Qrome/QLiteOSD/images/preview.jpg

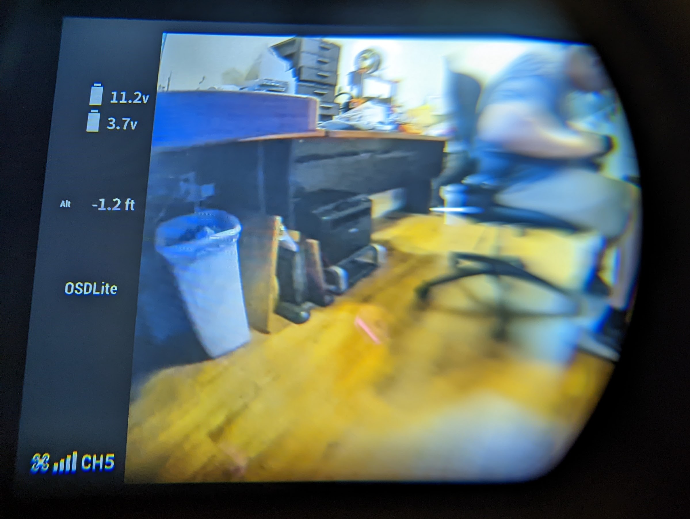
images/preview.jpg
