Qrome/QLiteOSD/images/PXL_20220612_231718759.jpg

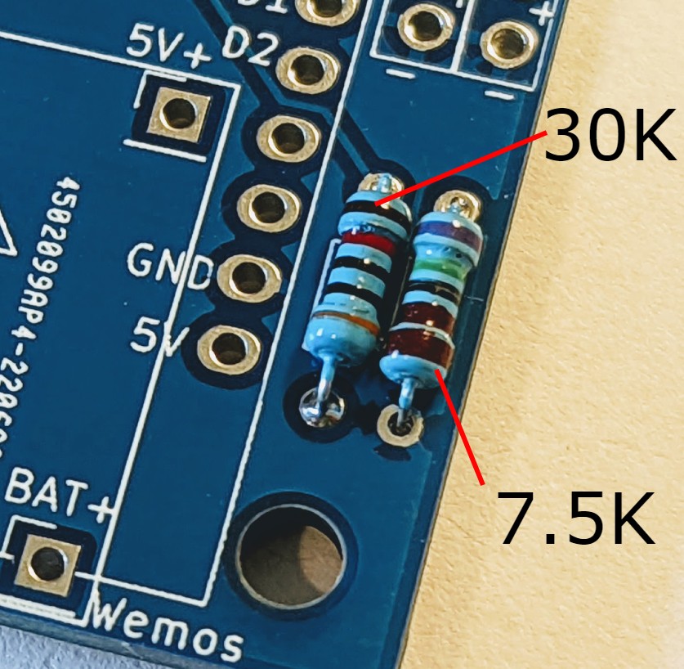
images/PXL_20220612_231718759.jpg
