Qrome/QLiteOSD/images/testing_unit.jpg

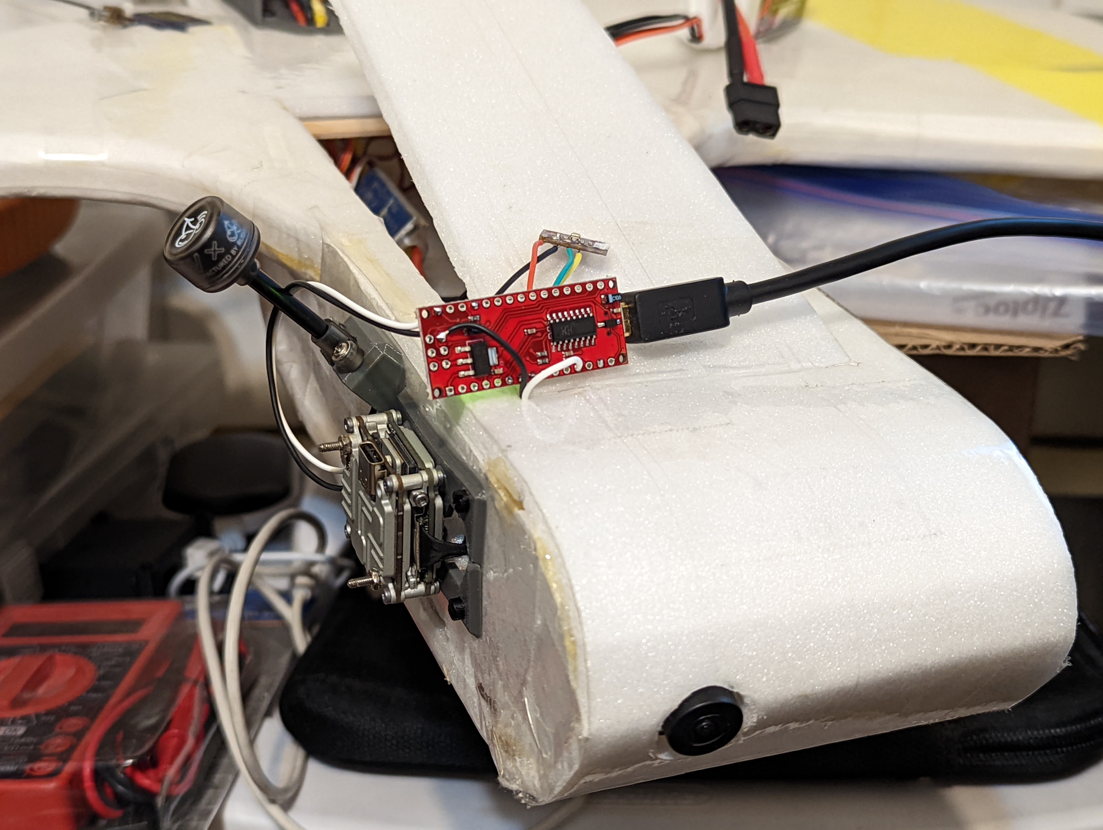
images/testing_unit.jpg
