Qrome/QLiteOSD/(threads)

Thread 1 (2022-09-04):

Add current sensor

01Space, 2022-09-04:
The DJI OSD you designed is very good! Can you add current sensor and qmc5883l?

01Space, 2022-09-06:
I am using esp8285s to design a customized version of DJI OSD, including current sensor and PDB, bec

Closed 2022-09-27.

Thread 2 (2023-01-17):

Instructions for using arduino nano

3dpete, 2023-01-17:
Hi  great project
I see you have arduino nano as an option as possible hardware on the parts list but no instructions on how to set up ? I wanted to use the nano as I have a few lying around Cound you add how to use I asked painless 360 as you reference his set up video but he was not sure ?
Any advice would be appreciated.

Qrome, 2023-01-19:
It has been a while since I initially coded and tested with the Arduino Nano, but I think it may still work.
In the OSD_positions_config.h -- fine the line:
`#define ESP8266`
and comment that out.

The reason I stopped working with the Nano was it was more expensive than the Wemos D1 Mini and you don't get the speed or logging (memory) that you get with the ESP8266 core.

You will also have to read through the code in the INO file for the pins -- they are there.

3dpete, 2023-01-19:
Hi I managed to get it working on arduino nano.  barro is working and osd
display is working but voltage is just showing 0v have set up with voltage
divider as your recommendation on pin a0 but not getting read out any ideas
why would be helpful. Thanks

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

Qrome, 2023-01-19:
I am quite sure the Voltage divider should work on the Nano as that is where I originally tested it out.  I don't know, off the top off my head, why you would not be able to read the voltage.

3dpete, 2023-01-19:
thanks for getting back to me so fast, could it be anything to do with
speed/refresh rate? I'm not a coder, just have a little knolage how to
compile and comment in/out things from the multi wii days ?:)
I have an esp8266 nodemcu with wifi I found in my parts bin would this also
work?
would love to get this working maybe I just get the wemos d1  is it
thanks pete

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

Qrome, 2023-01-19:
I have also created a more simple version called VoltOSD using the XIAO SAMD21

 *  VoltOSD
 *
 *  XIAO SAMD21 TX to DJI Air unit RX(115200)
 *  Voltage sensor on A0 pin 0
 *  PWM Arm Signal on D1 pin 1

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

https://github.com/Qrome/VoltOSD

3dpete, 2023-01-19:
that looks great supper compact !!  dude your a wizard, using the
balance lead is a great idea. xiao board is a little more expensive from
what I can see, would still love to get it working on the nano  as I have a
bag of 10 of them left over from a old project just need to get the volts
showing will play with it tonight a little more. see if I can work it out
did try to us the serial monitor to see if I could see volt read out on
that. could it be that I have the dji unit set up for inav on wtfos hack so
using compressed transmission msp? blow is cut and past from wtfos wiki so
you can see

Compressed Transmission

As of 0.7.0, a new option, compress_osd, has been added to the air side
process.

If this is set to "true", then the entire character buffer will be sent
using LZ4 compression at the rate defined in osd_update_rate_hz, instead of
sending raw MSP messages over the air.

When enabled, this should fix INAV delta update related issues as well as
provide better link stability.

To enable:

Use the CLI button in the configurator on your VTx side after updating to
0.7.0.

package-config set msp-osd compress_osd true
package-config apply msp-osd

If the apply hangs, just reboot your VTx.

Note that INAV HD mode sync issues may still be present, use the usual
workarounds (enter menu or switch screens) to fix these.

Compressed mode may also be valuable for other FCs, as it should make the
overall link much more reliable and stable

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

3dpete, 2023-01-19:
would i need to change anthing in here pasted code below  for  voltage read
out to work on nano?.
 and also can I just change the
 analogPin =  A0
to a different pin ?
in here to check if the problem is the pin i.e can I just change to A2 ? or
will it break the code somewhere else ?

//Voltage and Battery Reading
#ifdef ESP8266
const float arduinoVCC = 3.25;  //Measured ESP8266 3.3 pin voltage
#else
const float arduinoVCC = 5.0;  //Measured Arduino 5V pin voltage
#endif
float ValueR1 = 7500;   //7.5K Resistor
float ValueR2 = 30000;  //30K Resistor
const int alanogPin = A0;
float averageVoltage = 0;
int sampleVoltageCount = 0;other to see if the my a0 pin is broken ?

On Thu, 19 Jan 2023 at 17:59, peter houghton ***@***.***>
wrote:

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

3dpete, 2023-01-19:
did work still trying

ramiss, 2023-07-30:
Please note that this project has switched to using the Seeeduino SAM21 chipset.

Thread 3 (2023-07-01):

issues disarming?

ramiss, 2023-07-01:
Hi there!  Thanks for this code.  Its working great for me and the DJI air unit arms and starts recording.  the issue is that the air unit won't respond to a disarm msp command.  Have you seen this issue and do you have any insight?

Thanks!

Qrome, 2023-07-02:
The QLiteOSD defaults to arm with the change in altitude -- it does not know anything about your disarm from your radio unless you have compiled and turned on the option USE_PWM_ARM  --when using this option you can define a switch to arm and disarm if you run a signal and ground from your RC Rx channel to D5 pin.    Otherwise, you only get the arm action when there is a change in altitude of 1.5 meters.  I hope that helps.

ramiss, 2023-07-02:
> The QLiteOSD defaults to arm with the change in altitude -- it does not know anything about your disarm from your radio unless you have compiled and turned on the option USE_PWM_ARM --when using this option you can define a switch to arm and disarm if you run a signal and ground from your RC Rx channel to D5 pin. Otherwise, you only get the arm action when there is a change in altitude of 1.5 meters. I hope that helps.

Hey and thanks for the response.  Apologies as I wasn't nearly clear enough.  I'm using the same dji flightmodeflags as you to arm and disarm in my own project and although the arm flag works, the disarm flag rarely works.  its weird, because it works about 1 in 5 times on my 03 air unit (which should be using the same msp protocols as the original air unit/caddx).  I was curious if you've had similar issues with your code?

Qrome, 2023-07-02:
It works in my code.   I have not looked at that code for a while but I use it and is working.

PPPRY, 2023-07-11:
I can not get the latest code to upload using a ESP32-S3-Box has anyone run into any issues flashing? Compilation error: 'LED_BUILTIN' was not declared in this scope @ramiss

ramiss, 2023-07-11:
> I can not get the latest code to upload using a ESP32-S3-Box has anyone run into any issues flashing? Compilation error: 'LED_BUILTIN' was not declared in this scope @ramiss

So first of all, I'm not the owner of this code, this thread was for my issue.  Second, you need to post your own issue as your problem has nothing to do with not disarming.

PPPRY, 2023-07-11:
> > I can not get the latest code to upload using a ESP32-S3-Box has anyone run into any issues flashing? Compilation error: 'LED_BUILTIN' was not declared in this scope @ramiss
>
> So first of all, I'm not the owner of this code, this thread was for my issue. Second, you need to post your own issue as your problem has nothing to do with not disarming.

Gotcha thanks for reaching out first time posting!

PPPRY, 2023-07-11:
> I can not get the latest code to upload using a ESP32-S3-Box has anyone run into any issues flashing? Compilation error: 'LED_BUILTIN' was not declared in this scope

Sorry disregard this..

Closed 2023-07-02.

Thread 4 (2023-07-20):

Support the battery to 6s

astray1988, 2023-07-20:
I would expect to have 6s battery(4.2v for Lipo, 4.35 for LiHV) supported in the future release.

Qrome, 2023-07-20:
It is a hardware limitation.   The you can run what ever your voltage stepdown can handle.   Also, you need to also stay under the voltage limit of your DJI video transmitter unless you use a voltage step down for that as well.   There will be no code changes for this request.

Closed 2023-07-20.

Thread 6 (2024-01-07):

Cannot flash device

Iamyahodfpv, 2024-01-07:
I downloaded the drivers and the device shows up as com3 but when I try to flash nothing happens. Also when plugged in the blue led flashes and then turns off.

Qrome, 2024-01-07:
Make sure you are using a data cable and not just a charging cable.   Try a new cable and a different USB Port.  This is not a software issue.

Iamyahodfpv, 2024-01-07:
I've tried different cables and I am using a data cable. Is it possible that I bricked it? Also can it be flashed through arduino IDE or does it have to be flashed with the PYflasher?

Iamyahodfpv, 2024-01-07:
Tried uninstalling and reinstalling the Pyflasher and the serial port showed up but now when I try to flash it is stuck on connecting

Iamyahodfpv, 2024-01-07:
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

Qrome, 2024-01-07:
Remove the board from the socket and just load it to the wemos d1 mini ... I have seen bridged soldering cause the board to not connect.

Qrome, 2024-01-07:
Yes, you can compile and load the firmware using Arduino IDE.

Iamyahodfpv, 2024-01-07:
Yep that did the trick. Now just need to figure out what's bridged

Qrome, 2024-01-07:
Post some photos of the top and bottom of the main board.   Did you do the button for the Wifi mode?   Check that the D3 and GND are not connected.

Thread 7 (2024-01-19):

GPS not working

Iamyahodfpv, 2024-01-19:
I currently have a foxeer m10 wired up and am not getting any gps info.

Qrome, 2024-01-19:
Are you seeing any of the other OSD elements?

Iamyahodfpv, 2024-01-19:
Yes, just not getting info from the gps

Iamyahodfpv, 2024-01-19:
The gps elements are there but no values show up

Iamyahodfpv, 2024-01-19:
The gps is a m10q 250, is there something I need to change in the config?

Iamyahodfpv, 2024-01-19:
Also the baud rate is 115200

Qrome, 2024-01-19:
You can change the baud rate in the firmware and compile it on your own.   The default is expecting 9600.   If you need me to compile it, let me know.

Qrome, 2024-01-19:
It is part of the QLiteOSD.ino code.   Near line 58.

`static const uint32_t GPSBaud = 9600;`

Change 9600 to 115200 and compile it.   If you are not able to compile it, let me know the options you want and I can do it for you.

Iamyahodfpv, 2024-01-19:
Well when I plugged the board back in I didn’t have the pins lined up and I think I may have bricked it. Is there a way to fix that?

Iamyahodfpv, 2024-01-19:
Now I’m just getting a solid blue light and no osd

Qrome, 2024-01-19:
Yeah, reversing the plugs can toast the Wemos D1 Mini board -- good news is you can replace those.

Iamyahodfpv, 2024-01-19:
Is it worth trying to uninstall and reinstall the drivers? It doesn’t smell like I smoked anything.

Iamyahodfpv, 2024-01-19:
I didn’t plug it in the wrong way just miss aligned the pins by one slot

Qrome, 2024-01-19:
I have seen it toast the Wemos D1 mini if the pins get plugged in wrong.   Solid light or not light is an indicator.   Remove the Wemos D1 mini from the socket and try to run it off the USB cable and or load it again -- if it will not load of the LED start flashing then it got toasted.   They are easy to replace.

Iamyahodfpv, 2024-01-19:
Yeah not getting anything when plugged into usb, it shows up but won’t connect

Qrome, 2024-01-19:
Yeah, sorry to hear that.

Iamyahodfpv, 2024-01-21:
Okay so I got the new board, flashed it but when I plug it in I'm not getting anything. No flashing led when plugged into the board but it does flash when plugged into my computer

Qrome, 2024-01-22:
That's an indicator that there might be a bad solder joint or joined pins.  Did you solder the d3 pin and gnd for wifi mode?  If so, make sure that is correct.

Qrome, 2024-01-22:
Post some photos of the board.

Iamyahodfpv, 2024-01-22:
It was the button for the WiFi, removed it and now it works. But still am not getting gps info

Iamyahodfpv, 2024-01-22:
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

Iamyahodfpv, 2024-01-22:
I changed the baud rate but still no gps data in the osd. I wired up the gps to a quad to make sure it wasn't the gps and it worked fine on that

Qrome, 2024-01-22:
Make sure you have the TX to RX pins correct. Try to swap them.  Also, you may need to take it outside to get satellites.

Iamyahodfpv, 2024-01-22:
Rx is going to tx and tx to rx

Iamyahodfpv, 2024-01-22:
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

Iamyahodfpv, 2024-01-22:
It's weird that it is showing 14 sats but no longitude or latitude

Qrome, 2024-01-22:
If it is flashing 14 then it is actually no satellites.  Try it outside... Satellite link may require you to have it outside.

Iamyahodfpv, 2024-01-22:
The gps is blinking green, which means it has a lock. I'll try switching around rx and rx but they are wired the way they should be

Iamyahodfpv, 2024-01-22:
*rx and tx

Qrome, 2024-01-22:
Then, maybe that GPS is not compatible.

Iamyahodfpv, 2024-02-26:
Would there be any changes I need to make to the code for an m10 without a compass?

Qrome, 2024-02-26:
The project is using the TinyGPS++ library.   You may want to check over on that project for compatibility.

Thread 8 (2024-01-22):

Issue getting osd

Iamyahodfpv, 2024-01-22:
Okay so I got the new d1 board, flashed it but when I plug it in I'm not getting anything. No flashing led when plugged into the board but it does flash when plugged into my computer

Qrome, 2024-01-22:
Ok so you have now created a second issue thread for hardware support.  Let's not muddy up the code repo here.  Please reach out to me directly.

Closed 2024-01-22.

Thread 10 (2024-03-10):

No output to Google 2 with O3 Air Unit

markandkymward, 2024-03-10:
No OSD output to Goggles 2 with O3 Air Unit
1. Blue flashing light on unit
2. Soldering verified
3. Power verified
4. Image verified (GPS, IMPERIAL)
5. Goggles Menu Display>Canvas mode (the only option) > either Normal or HD, no joy on either.
6. Verified TX to Airunit RX (white wire on original connector)
7. Good video in low power mode. Raised 1.5m after powerup with no change

Qrome, 2024-03-10:
That is correct -- if you read the NOTE at the top of the readme.md it says it is NOT compatible with the DJI 03 Air Unit.   It also says this on the product page when you go to purchase it.   Very sorry.  I do not know why DJI chose to change the platform so drastically from the original Air Units and Vista light units.

Closed 2024-03-10.
