Qrome/QLiteOSD/(commit log)

2022-10-10 Added PWM arming and disarming option
2022-11-11 updated GPS TX and RX pins to match the board
2023-12-27 Updated log file naming to include device ID
2024-01-12 Cleaned up unused variables and updated for Arduino Nano boards
2024-01-27 fixed minor bug in GPS log file where the track name was not correct
    [OSD_positions_config.h, QLiteOSD.ino]
